FranciscoRozenberg/TDCE/README.md

Proyecto Integrador para cursada de Taller de Circuitos Electrónicos - 2C2026 - FIUBA
