FranciscoRozenberg/TDCE/capturas/Compensaciones/Screenshot_20260924_173537.png

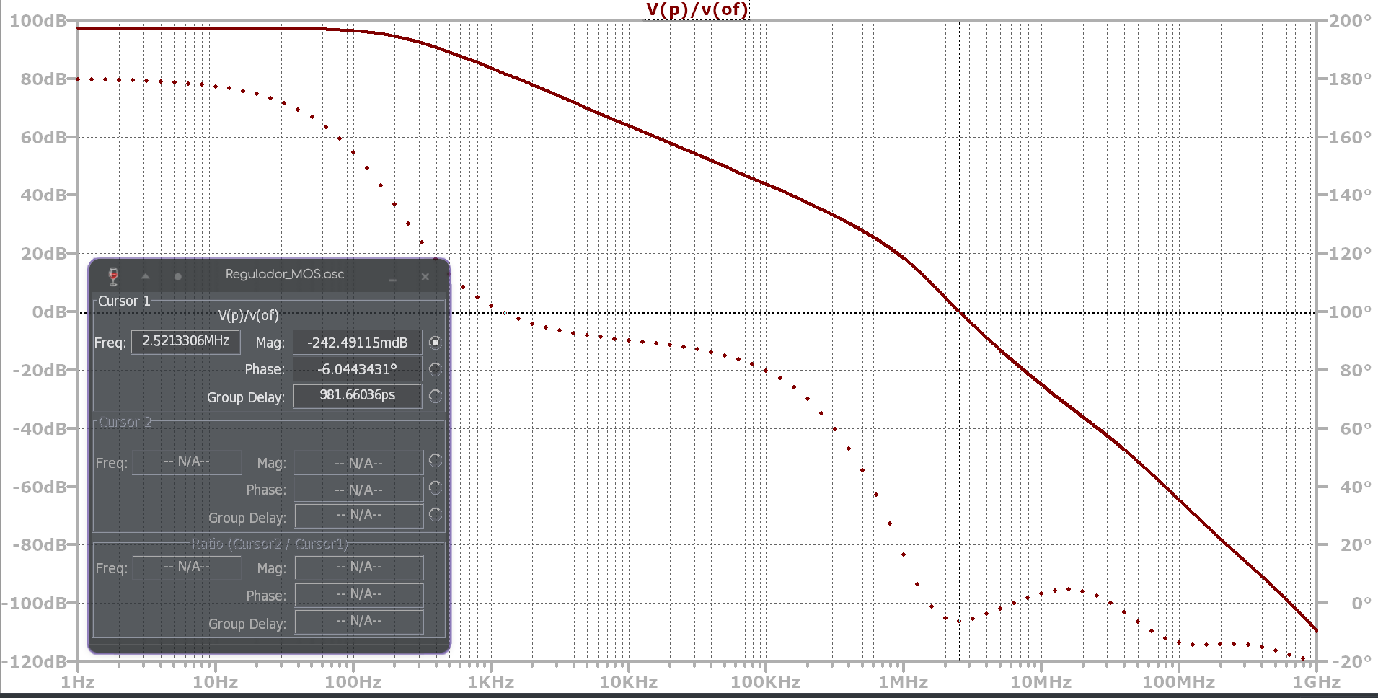
capturas/Compensaciones/Screenshot_20260924_173537.png
