FranciscoRozenberg/TDCE/capturas/Compensaciones/Screenshot_20260924_173708.png

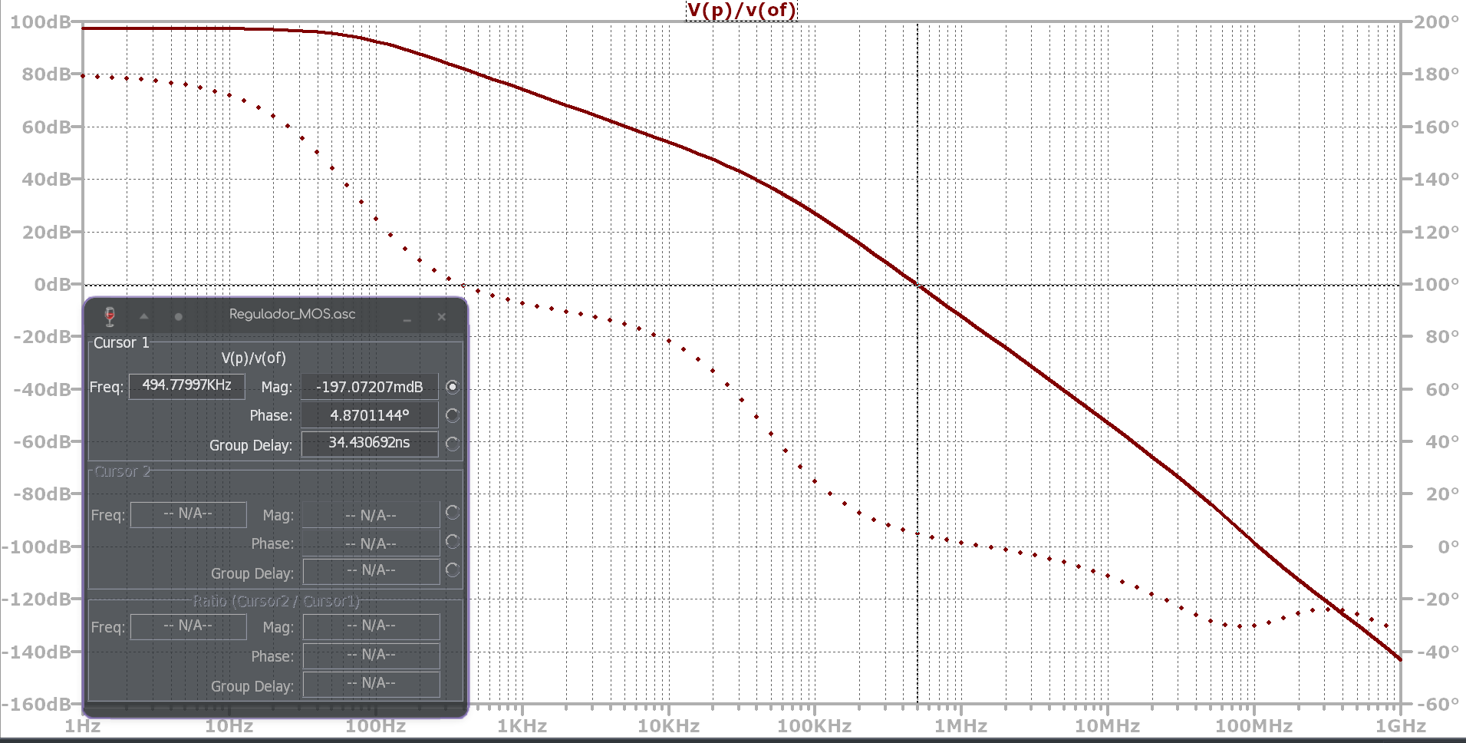
capturas/Compensaciones/Screenshot_20260924_173708.png
