FranciscoRozenberg/TDCE/capturas/Compensaciones/Screenshot_20260924_173938.png

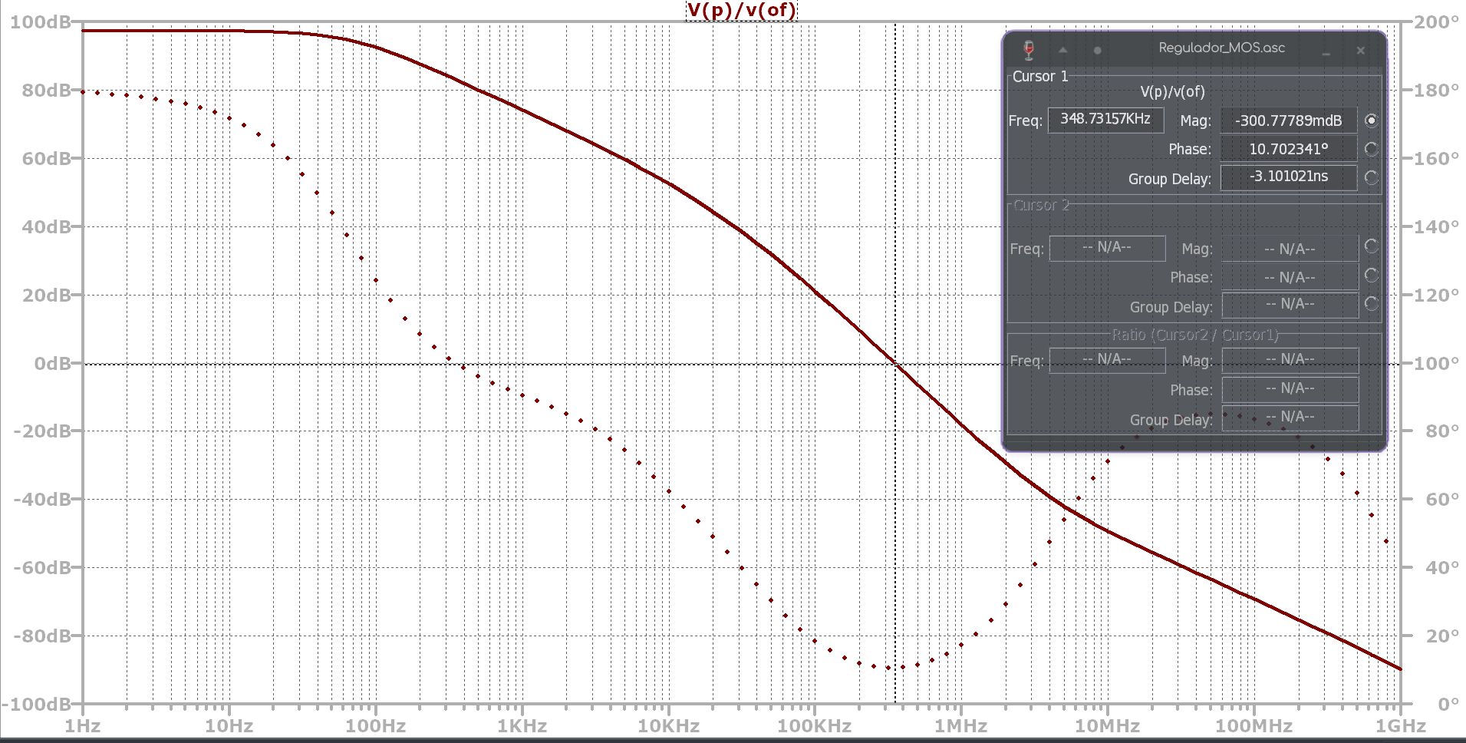
capturas/Compensaciones/Screenshot_20260924_173938.png
