FranciscoRozenberg/TDCE/capturas/Compensaciones/Screenshot_20260924_174028.png

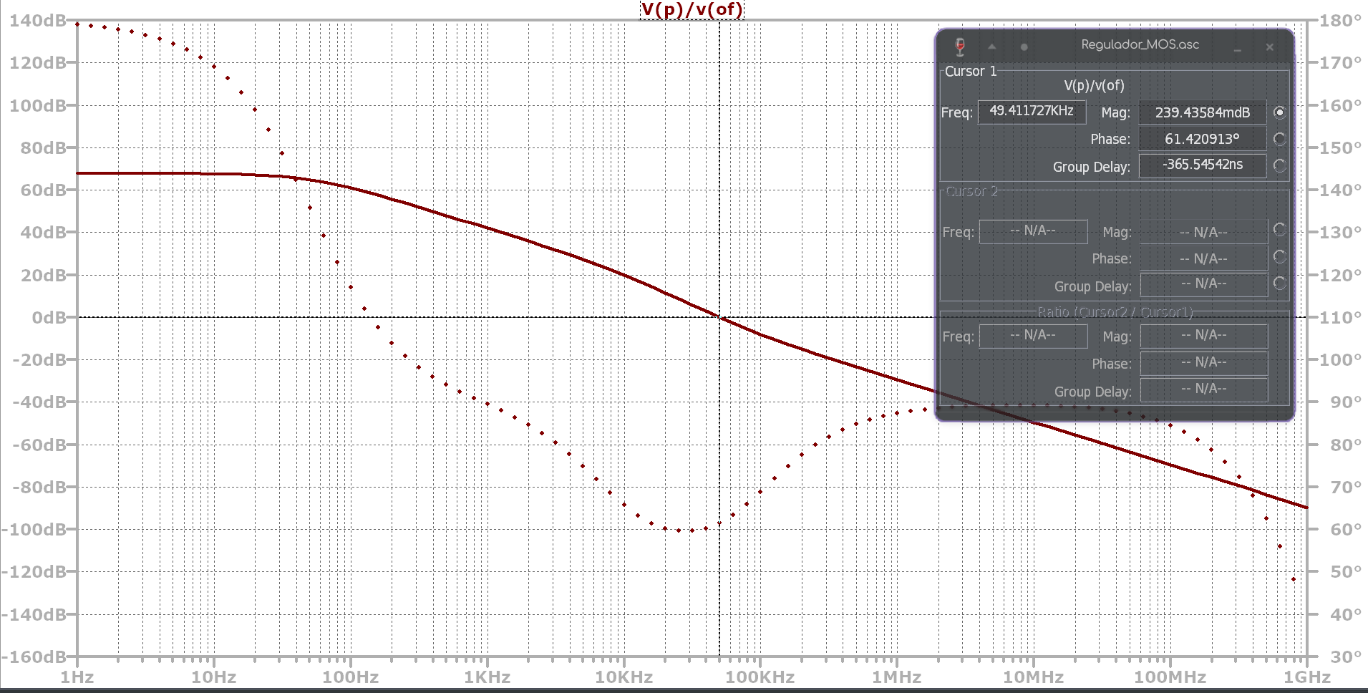
capturas/Compensaciones/Screenshot_20260924_174028.png
