FranciscoRozenberg/TDCE/capturas/Compensaciones/Screenshot_20260924_174857.png

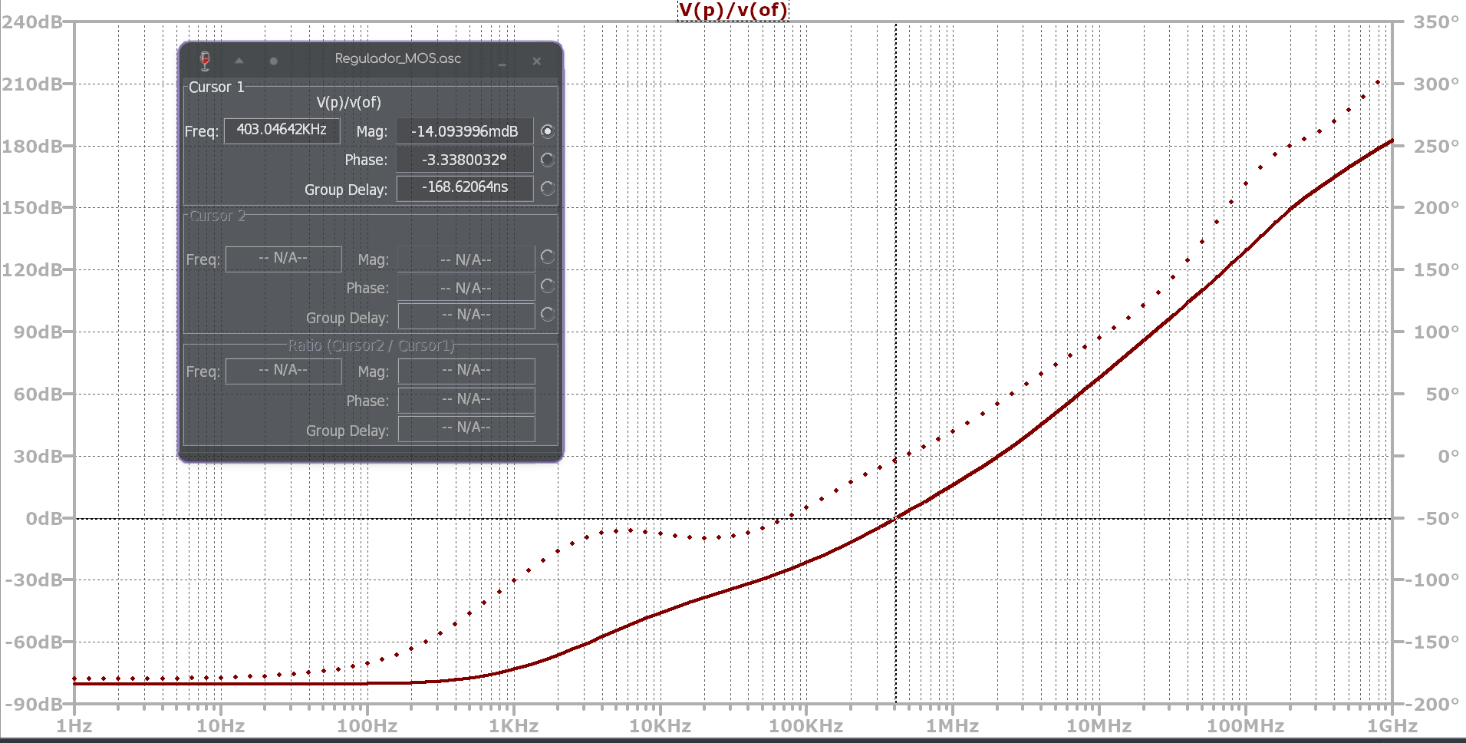
capturas/Compensaciones/Screenshot_20260924_174857.png
