FranciscoRozenberg/TDCE/capturas/Compensaciones/Screenshot_20260924_181137.png

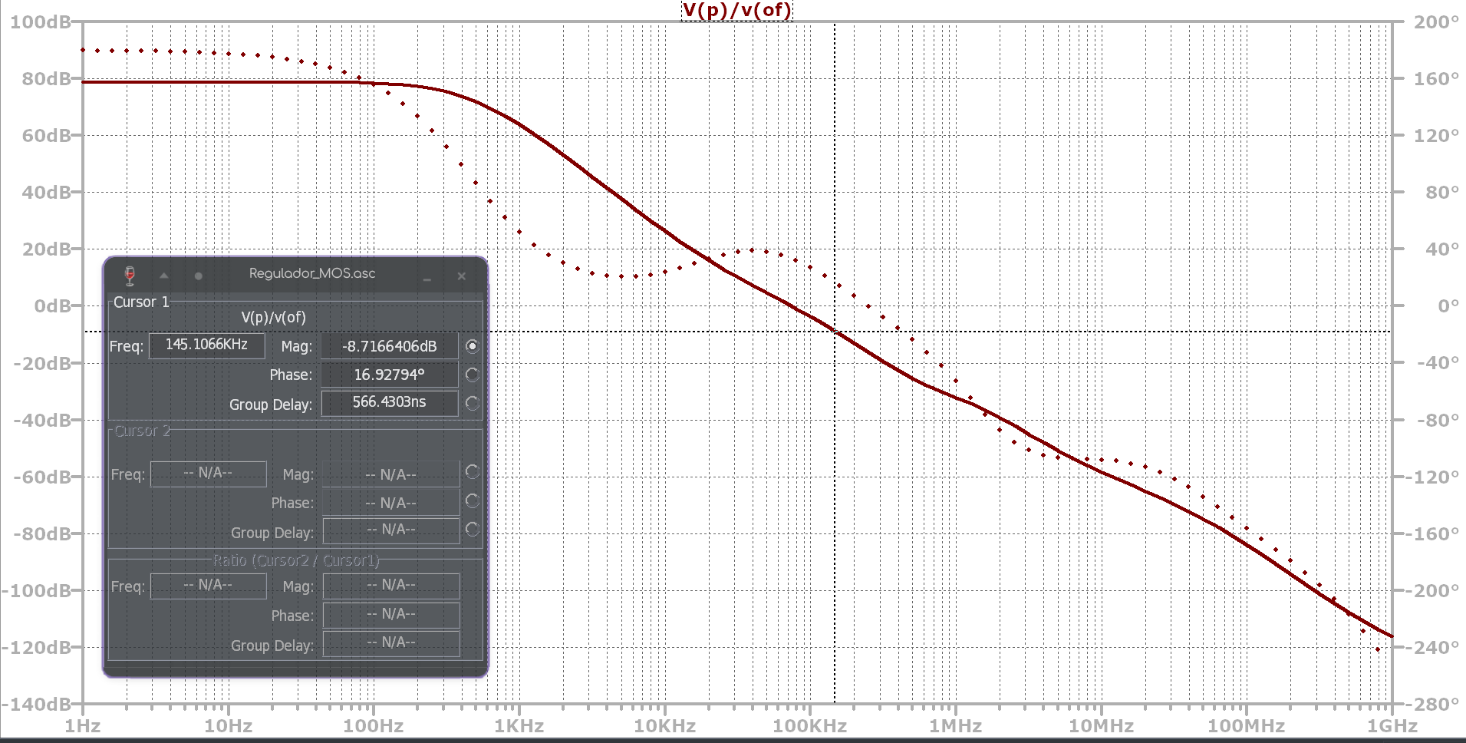
capturas/Compensaciones/Screenshot_20260924_181137.png
