FranciscoRozenberg/TDCE/capturas/Compensaciones/Screenshot_20260924_181226.png

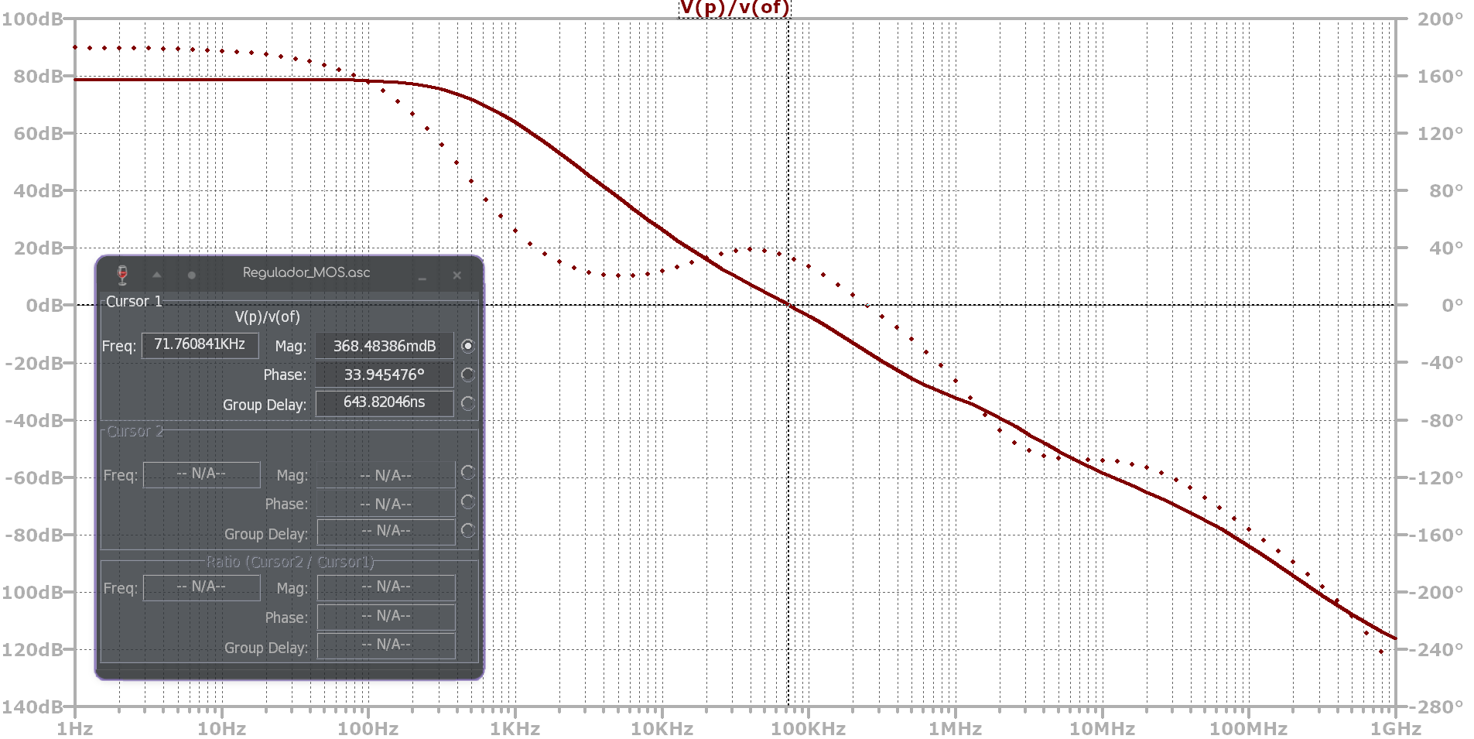
capturas/Compensaciones/Screenshot_20260924_181226.png
