FranciscoRozenberg/TDCE/capturas/foldback.jpg

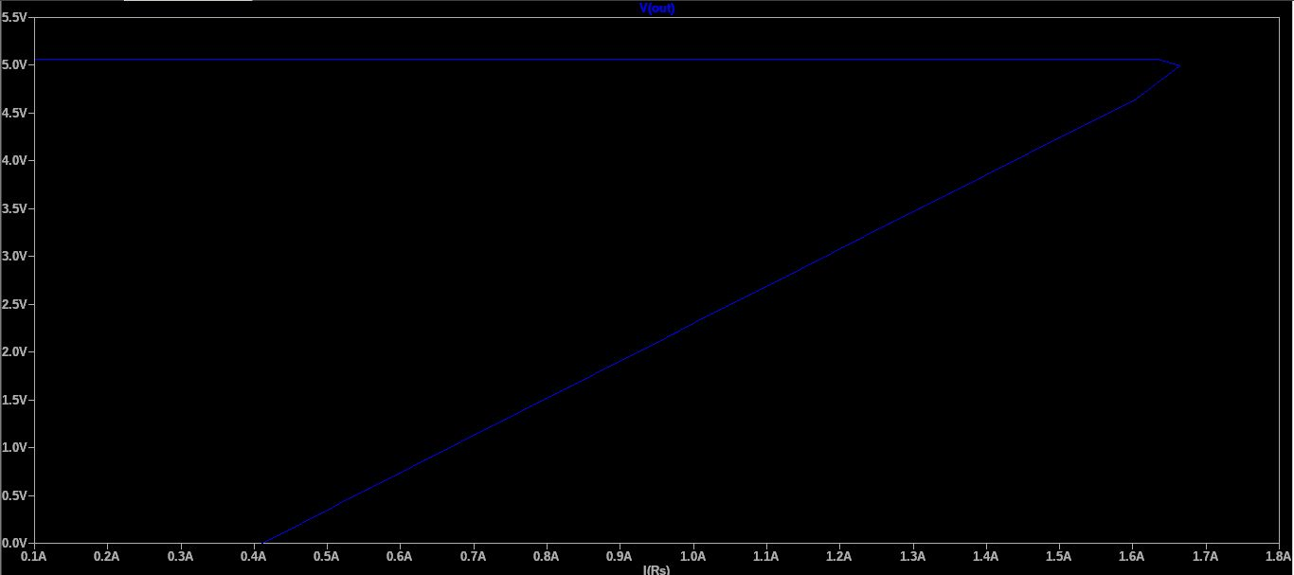
capturas/foldback.jpg
