FranciscoRozenberg/TDCE/capturas/MF_con_IRF9Z34N.png

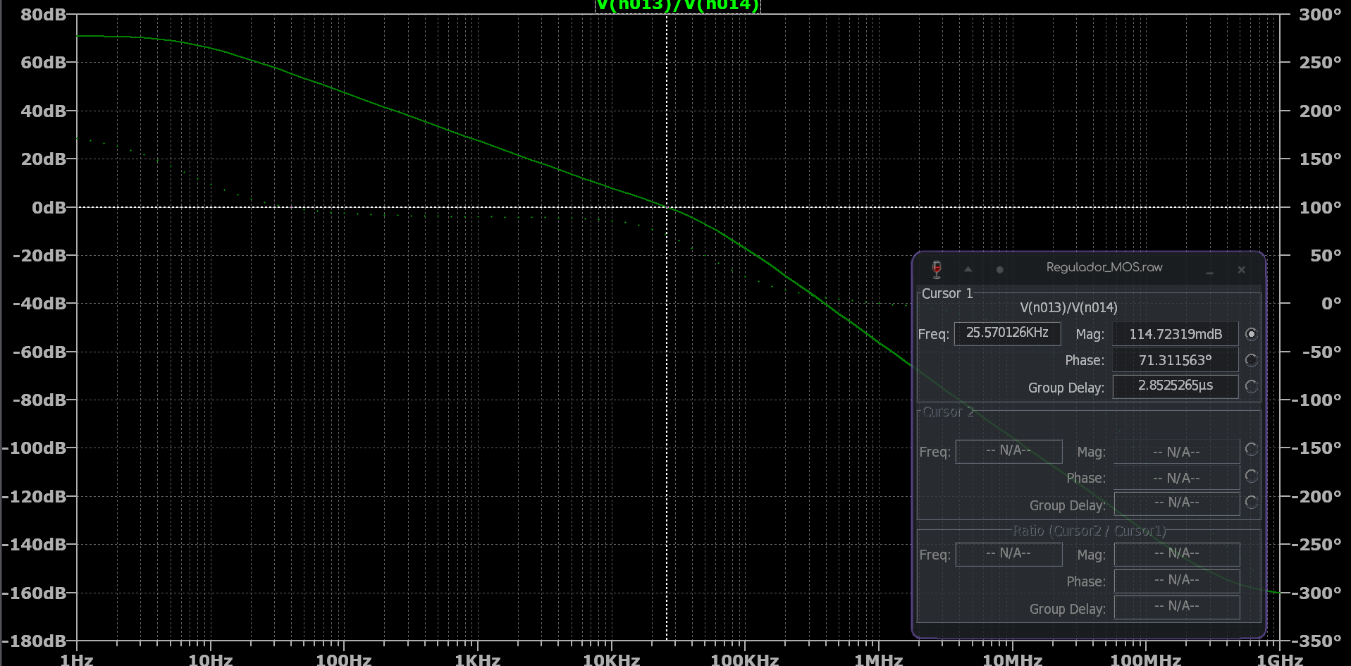
capturas/MF_con_IRF9Z34N.png
