FranciscoRozenberg/TDCE/capturas/PCB/PCB_DETRAS.png

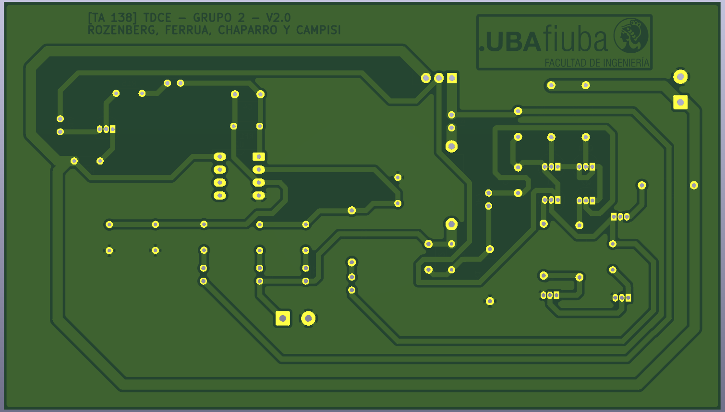
capturas/PCB/PCB_DETRAS.png
