FranciscoRozenberg/TDCE/capturas/screenshot regulador.png

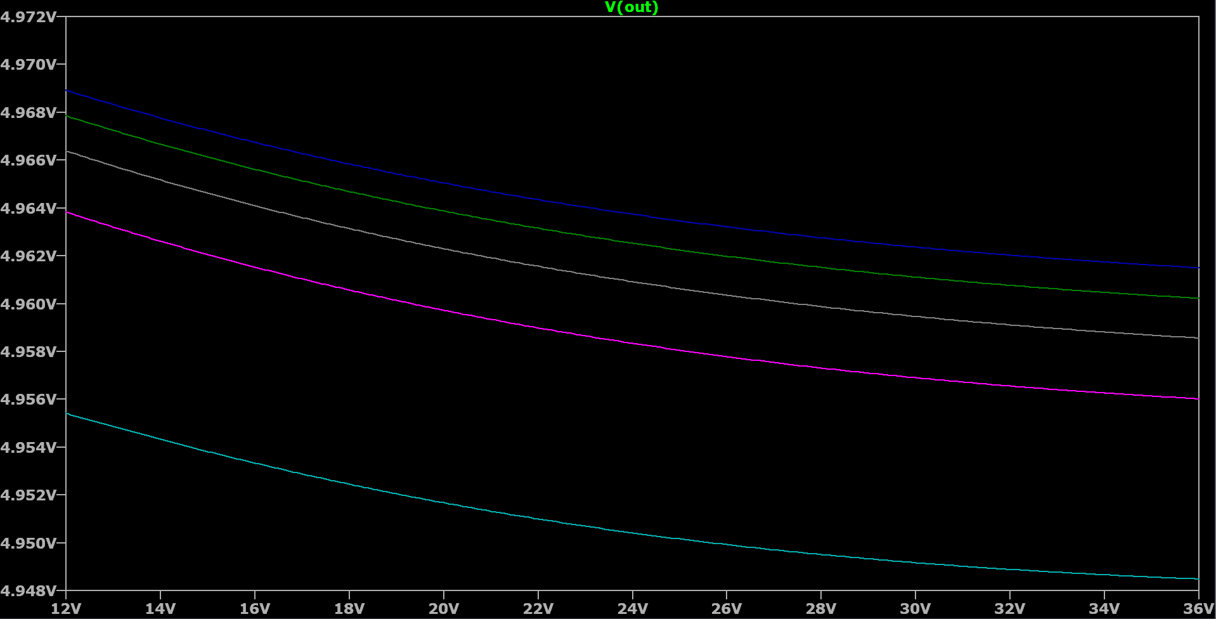
capturas/screenshot regulador.png
