FranciscoRozenberg/TDCE/IMG-20260925-WA0036.jpg

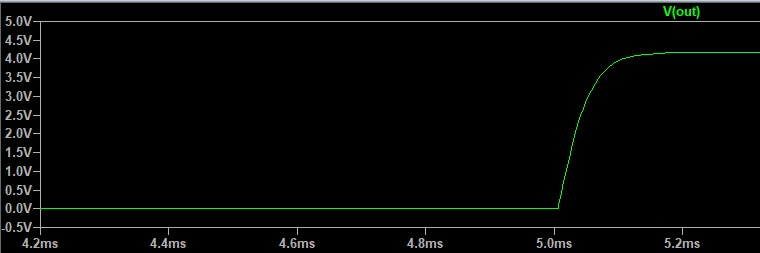
IMG-20260925-WA0036.jpg
