FranciscoRozenberg/TDCE/IMG-20260925-WA0037.jpg

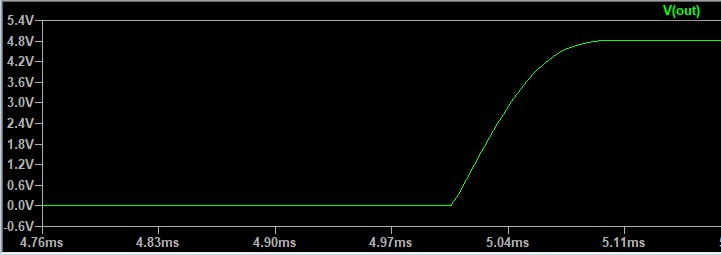
IMG-20260925-WA0037.jpg
