FranciscoRozenberg/TDCE/IMG-20260925-WA0038.jpg

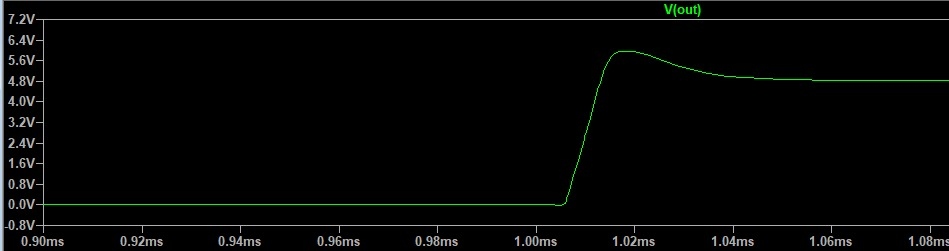
IMG-20260925-WA0038.jpg
