FranciscoRozenberg/TDCE/IMG-20260925-WA0039.jpg

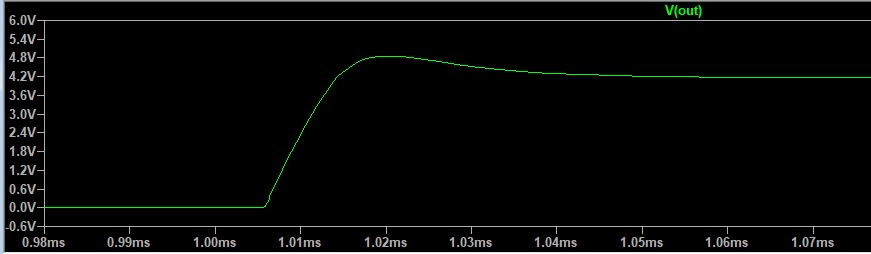
IMG-20260925-WA0039.jpg
