FranciscoRozenberg/TDCE/CH4_FUENTE_CONMUTADA/PWM_V2/pwm_V2/pwm_V2.csv

Reference | Qty | Value | DNP | Exclude from BOM | Exclude from Board | Exclude from Simulation | Exclude from Position Files | Footprint | Datasheet
C1 | 1 | 10n |  |  |  |  | ${EXCLUDE_FROM_POS_FILES} | Capacitor_THT:C_Disc_D10.0mm_W2.5mm_P5.00mm
C_FIL1 | 1 | 1n |  |  |  |  | ${EXCLUDE_FROM_POS_FILES} | Capacitor_THT:C_Disc_D10.0mm_W2.5mm_P5.00mm
J1,J2 | 2 | Screw_Terminal_01x02 |  |  |  |  | ${EXCLUDE_FROM_POS_FILES} | TerminalBlock:TerminalBlock_MaiXu_MX126-5.0-02P_1x02_P5.00mm
JP1,JP2,JP3,JP4 | 4 | Jumper_2_Bridged |  |  |  |  | ${EXCLUDE_FROM_POS_FILES} | TestPoint:TestPoint_2Pads_Pitch2.54mm_Drill0.8mm
R1 | 1 | 100k |  |  |  |  | ${EXCLUDE_FROM_POS_FILES} | Resistor_THT:R_Axial_DIN0207_L6.3mm_D2.5mm_P10.16mm_Horizontal
R5 | 1 | 8k2 |  |  |  |  | ${EXCLUDE_FROM_POS_FILES} | Resistor_THT:R_Axial_DIN0207_L6.3mm_D2.5mm_P10.16mm_Horizontal
RP1,RP2 | 2 | 10k |  |  |  |  | ${EXCLUDE_FROM_POS_FILES} | Potentiometer_THT:Potentiometer_Alps_RK163_Single_Horizontal
R_FIL1 | 1 | 100K |  |  |  |  | ${EXCLUDE_FROM_POS_FILES} | Resistor_THT:R_Axial_DIN0207_L6.3mm_D2.5mm_P10.16mm_Horizontal
R_PU1,R_PU2 | 2 | 220 |  |  |  |  | ${EXCLUDE_FROM_POS_FILES} | Resistor_THT:R_Axial_DIN0207_L6.3mm_D2.5mm_P10.16mm_Horizontal
U1 | 1 | TL082 |  |  |  |  | ${EXCLUDE_FROM_POS_FILES} | Package_DIP:DIP-8_W7.62mm_LongPads | http://www.ti.com/lit/ds/symlink/tl081.pdf
U2 | 1 | LM393 |  |  |  |  | ${EXCLUDE_FROM_POS_FILES} | Package_DIP:DIP-8_W7.62mm_LongPads | http://www.ti.com/lit/ds/symlink/lm393.pdf
V1 | 1 | VSIN |  |  |  |  | ${EXCLUDE_FROM_POS_FILES} | TerminalBlock:TerminalBlock_MaiXu_MX126-5.0-02P_1x02_P5.00mm | https://ngspice.sourceforge.io/docs/ngspice-html-manual/manual.xhtml#sec_Independent_Sources_for
V2 | 1 | 12 |  |  |  |  | ${EXCLUDE_FROM_POS_FILES} | TerminalBlock:TerminalBlock_MaiXu_MX126-5.0-02P_1x02_P5.00mm | https://ngspice.sourceforge.io/docs/ngspice-html-manual/manual.xhtml#sec_Independent_Sources_for
