FranciscoRozenberg/TDCE/CH4_FUENTE_CONMUTADA/PWM/print_pcb_pwm.pdf

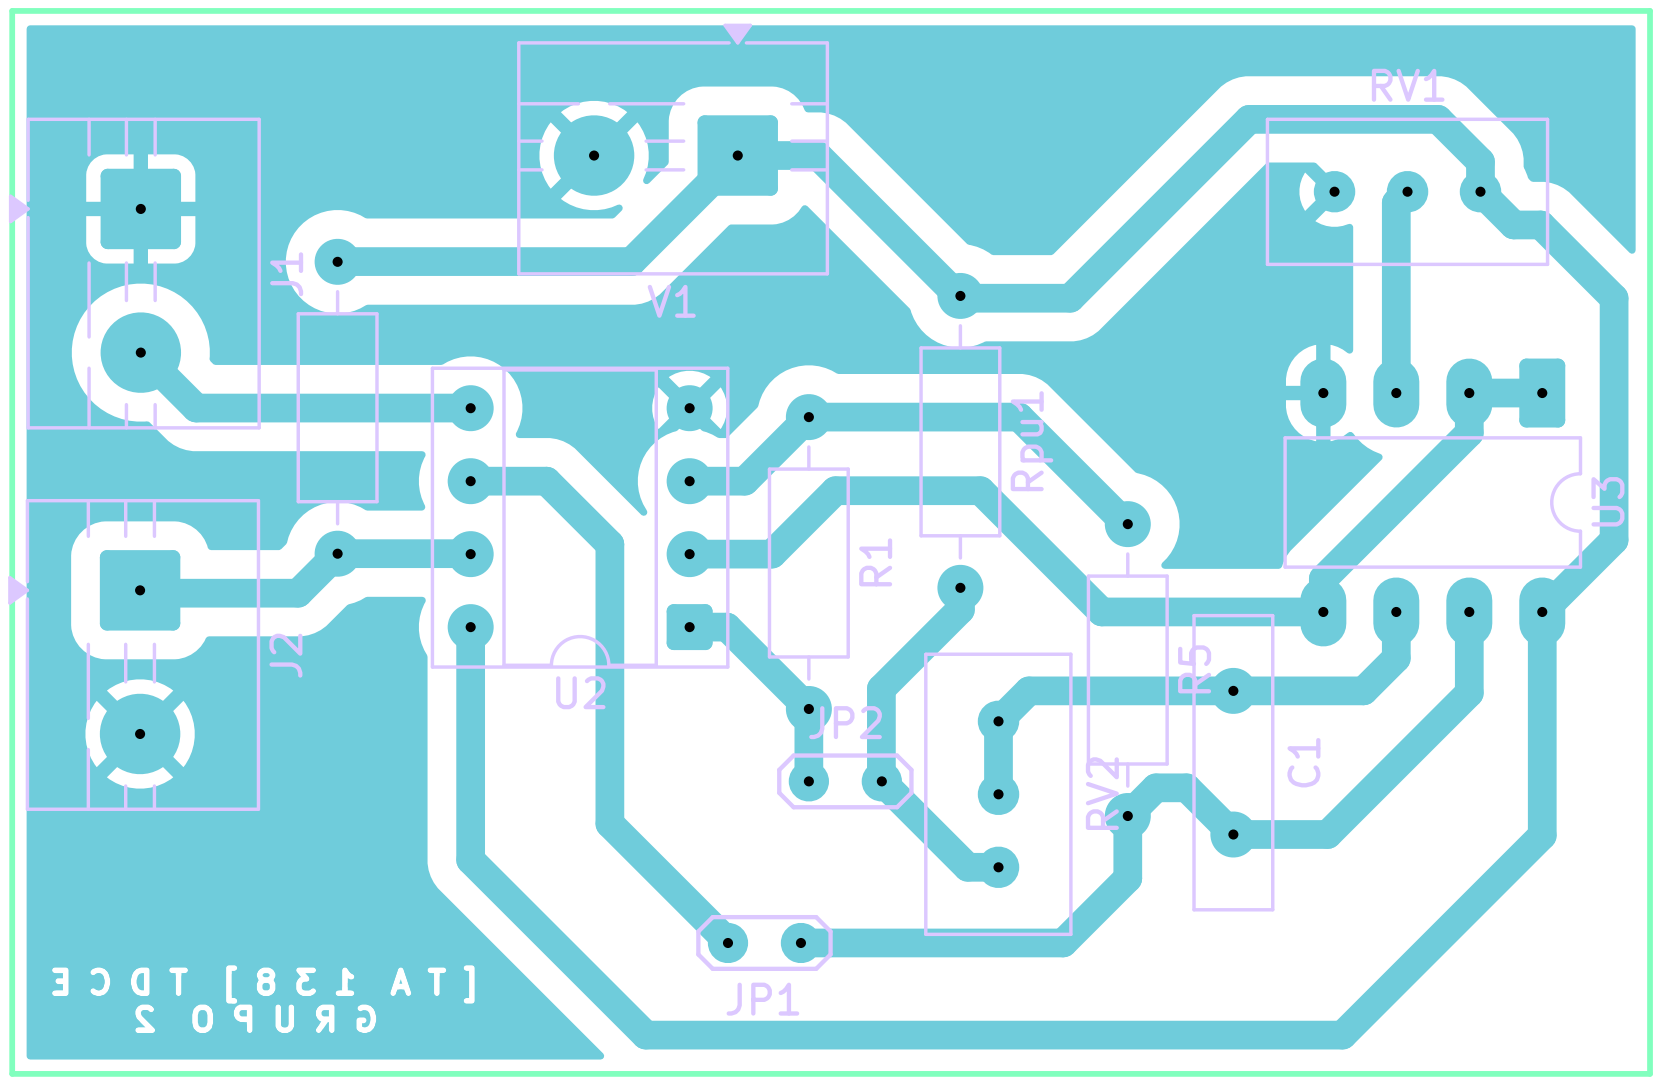
[picture p41: page 1]
