FranciscoRozenberg/TDCE/tests/Regulador_Diferencial_MOS.asc

M1: pmos; IRF9Z24S_L
Q1: npn; BC547C
Q2: npn; BC547C
Q3: npn; BC547C
Q4: npn; BC547C
Q5: pnp; BC557C
Q6: pnp; BC557C
R1: res; 10K
R2: res; 10K
R3: res; {RL}
R4: res; 3k3
R5: res; 6k6
V1: voltage; 7
VREF: voltage; 2.5
Named nets: 0, CC, OUT
;dc v1 4 7 0.1
.param RL 5
.op
