FranciscoRozenberg/TDCE/tests/Regulador_Diferencial.asc

I1: current; 1m
I2: current; 2m
Q1: npn
Q2: npn
Q3: npn
R1: res; 1k
R2: res; 1k
R3: res; {RL}
V1: voltage; 0
VREF: voltage; 2.5
Named nets: 0, CC
.dc v1 12 30 0.1
.step dec param RL 1m 10k 2
