FranciscoRozenberg/TDCE/tests/Regulador_Simple.asc

Q1: npn
Q2: npn
R1: res; 1k
R2: res; 1k
R3: res; {RL}
R4: res; 5k
V1: voltage; 0
V2: voltage; 1.8
Named nets: 0, CC
.dc v1 12 30 0.1
.step dec param RL 1m 10k 2
