FranciscoRozenberg/TDCE/Draft1.asc

C1: cap; 10n
R1: res; 100k
R2: res; 100k
R3: res; 100k
R4: res; 100k
R5: res; 47k
U1: opamp2
U2: opamp2
U3: opamp2
V1: voltage; 12
Named nets: 0, cc
.step param R 0 10k 2k
.op
.tran 0 1m 0 1u
