FranciscoRozenberg/TDCE/Regulador_MOS.asc

C1: cap; 1.5n
C2: cap; 820p
C3: cap; 1n
C4: cap; 1Meg
C5: cap; 1Meg
C6: cap; 15µ
C7: cap; 1n
L1: ind; 1Meg
L2: ind; 1Meg
M1: pmos; IRF9Z34N
Q1: pnp; BC557C
Q2: npn; BC547C
Q3: npn; BC547C
Q4: npn; BC547C
Q5: pnp; BC857C
Q6: pnp; BC857C
Q7: npn; BC547C
R1: res; 9.5k
R2: res; 39K
R3: res; 10.5k
R4: res; 1k8
R5: res; 39K
R6: res; 1k
R7: res; 1k
R8: res; 47K
R9: res; 47K
R10: res; 330k
R11: res; 1k
R12: res; 7k8
R13: res; 1
R14: res; 1
R15: res; 2.2k
R16: res; 2.2k
RF1: res; 330k
RL: res; 30
Rs: res; 0.1
Rz: res; 1k
U1: TL431
U2: lm358
V1: voltage; PULSE(0 2.5 100u 0 0 1ms 1ms)
V2: voltage; 0; AC 1
V3: voltage; 0; AC 1
VIN: voltage; {VINDC}; AC {VINAC}
Named nets: 0, CC, IN, OUT, VB, p, of
;step param RL 0.1 20 1
.op
Mido regulacion de linea
;.meas DC Vo1rl FIND V(out) AT=12
;.meas DC Vo2rl FIND V(out) AT=24
;.meas DC RegLin PARAM ((Vo2rl-Vo1rl)/12)
Mido regulacion de carga
;.meas OP Vo1rc FIND V(Vo) AT 100
;.meas OP Vo2rc FIND V(Vo) AT 5
;.meas OP Io1rc FIND I(RL) AT 100
;.meas OP Io2rc FIND I(RL) AT 5
Mido eficiencia
.param VINDC=10
.param VINAC 0
;.meas eficiencia PARAM -100*((V(out)*I(RL))/(V(CC)*I(VIN)))
.include IRF9Z34N.mod
.ac dec   10  1 1G
.dc VIN 5.5 6.5 0.01
.tran 2ms
