FranciscoRozenberg/TDCE/CH4_FUENTE_CONMUTADA/pwm1.asc

C1: cap; 1n
R1: res; 100k
R5: res; 8k2
Rp2: res; 10k
Rp3: res; 5k
Rp4: res; 5k
Rpu1: res; 220
Rpu2: res; 220
U1: opamp2; LM393A
U2: opamp2; TL072
U3: opamp2; TL072
U4: opamp2; LM393A
V1: voltage; 12
V2: voltage; SINE(6 1 12k)
Named nets: 0, cc, out
.step param R 0 10k 2k
.op
.tran 0 30u 0 1u
.include LM324.lib
.include LM393.lib
.include TL072.lib
