FranciscoRozenberg/TDCE/CH4_FUENTE_CONMUTADA/pwm_324.asc

C1: cap; 100p
R1: res; 100k
R2: res; 1k
R3: res; 1K5
R5: res; 27k
Rp2: res; 1K
Rp3: res; 5k
Rp4: res; 5k
Rpu1: res; 330
Rpu2: res; 330
U1: opamp2; LM393A
U2: opamp2; LM324
U3: opamp2; LM324
U4: opamp2; LM393A
V1: voltage; 12
V2: voltage; SINE(4 4 12k)
Named nets: 0, cc, out
.step param R 0 10k 2k
.op
.tran 0 30u 0 1u
.include LM324.lib
.include LM393.lib
.include TL072.lib
