FranciscoRozenberg/TDCE/CH4_FUENTE_CONMUTADA/PWM_V2/pwm_V2/pwm_V2.kicad_pcb

## KiCad design CH4_FUENTE_CONMUTADA/PWM_V2/pwm_V2/pwm_V2.kicad_pcb (2026-11-12)

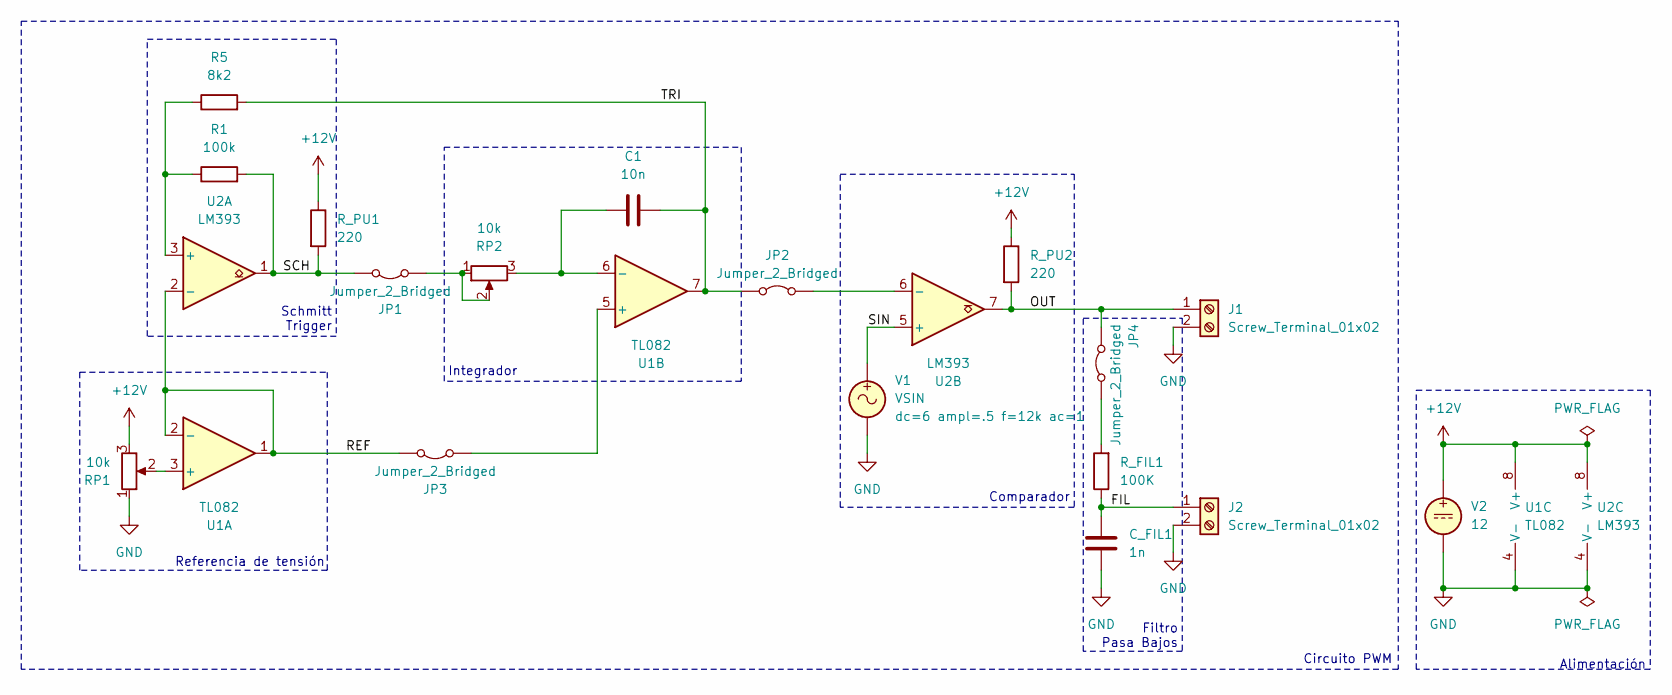
[picture p42: schematic pwm_V2.kicad_sch]

Parts:
C1: 10n; C_Disc_D10.0mm_W2.5mm_P5.00mm
C_FIL1: 1n; C_Disc_D10.0mm_W2.5mm_P5.00mm
J1, J2: Screw_Terminal_01x02; TerminalBlock_MaiXu_MX126-5.0-02P_1x02_P5.00mm
JP1, JP2, JP3, JP4: Jumper_2_Bridged; TestPoint_2Pads_Pitch2.54mm_Drill0.8mm
R1: 100k; R_Axial_DIN0207_L6.3mm_D2.5mm_P10.16mm_Horizontal
R5: 8k2; R_Axial_DIN0207_L6.3mm_D2.5mm_P10.16mm_Horizontal
RP1, RP2: 10k; Potentiometer_Alps_RK163_Single_Horizontal
R_FIL1: 100K; R_Axial_DIN0207_L6.3mm_D2.5mm_P10.16mm_Horizontal
R_PU1, R_PU2: 220; R_Axial_DIN0207_L6.3mm_D2.5mm_P10.16mm_Horizontal
U1: TL082; DIP-8_W7.62mm_LongPads
U2: LM393; DIP-8_W7.62mm_LongPads
V1: VSIN; TerminalBlock_MaiXu_MX126-5.0-02P_1x02_P5.00mm
V2: 12; TerminalBlock_MaiXu_MX126-5.0-02P_1x02_P5.00mm

Connections:
+12V: RP1.3, R_PU1.1, R_PU2.1, U1.8 (V+), U2.8 (V+), V2.1
/FIL: C_FIL1.1, J2.1, R_FIL1.1
/OUT: J1.1, JP4.2 (B), R_PU2.2, U2.7
/REF: JP3.1 (A), U1.1, U1.2 (-), U2.2 (-)
/SCH: JP1.1 (A), R1.2, R_PU1.2, U2.1
/SIN: U2.5 (+), V1.1
/TRI: C1.2, JP2.1 (A), R5.2, U1.7
GND: C_FIL1.2, J1.2, J2.2, RP1.1, U1.4 (V-), U2.4 (V-), V1.2, V2.2
unnamed: JP1.2 (B), RP2.1, RP2.2
unnamed: JP2.2 (B), U2.6 (-)
unnamed: JP3.2 (B), U1.5 (+)
unnamed: JP4.1 (A), R_FIL1.2
unnamed: RP1.2, U1.3 (+)
unnamed: C1.1, RP2.3, U1.6 (-)
unnamed: R1.1, R5.1, U2.3 (+)

Notes on the sheet:
Integrador
Referencia de tensión
Schmitt Trigger
Filtro Pasa Bajos
Alimentación
Circuito PWM
Comparador

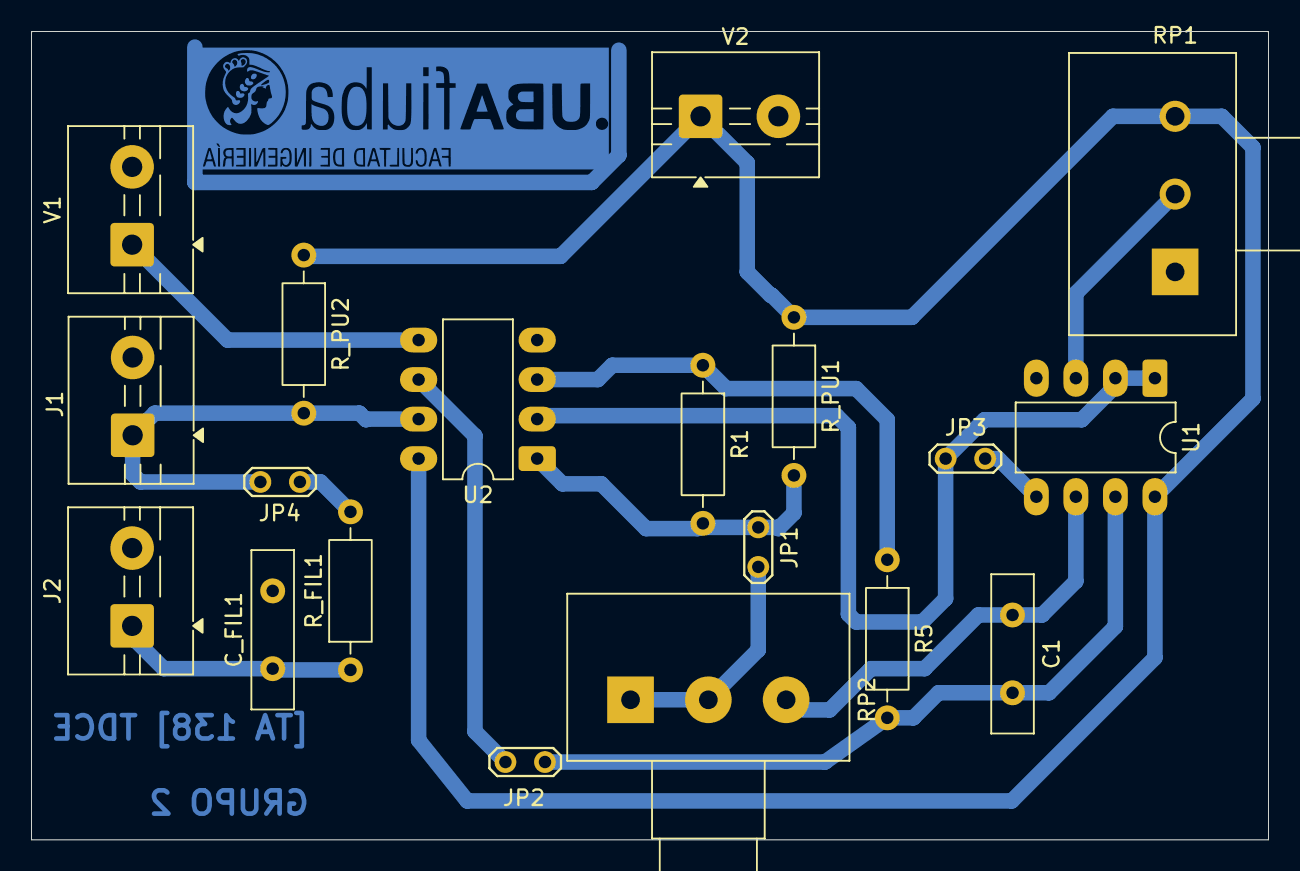
[picture p43: board pwm_V2.kicad_pcb from above]

Board: 2 copper layers, 79.5 x 52.0 mm, 19 parts (0 on the bottom side), 15 nets.
