FranciscoRozenberg/TDCE/CH4_FUENTE_CONMUTADA/PWM/PWM.kicad_pcb

## KiCad design CH4_FUENTE_CONMUTADA/PWM/PWM.kicad_pcb (2026-11-07, an earlier design)

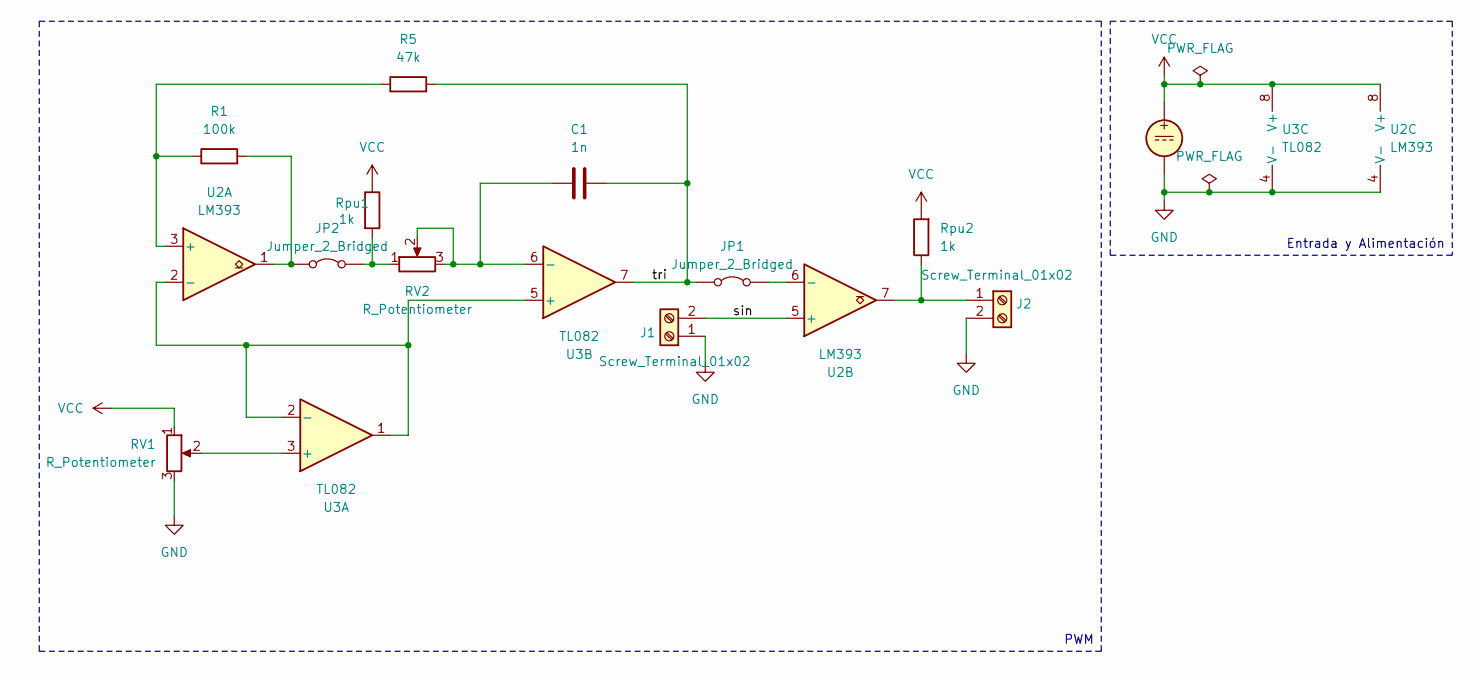
[picture p44: schematic PWM.kicad_sch]

Parts:
C1: 1n; C_Disc_D10.0mm_W2.5mm_P5.00mm
J1, J2: Screw_Terminal_01x02; TerminalBlock_MaiXu_MX126-5.0-02P_1x02_P5.00mm
JP1, JP2: Jumper_2_Bridged; TestPoint_2Pads_Pitch2.54mm_Drill0.8mm
R1: 100k; R_Axial_DIN0207_L6.3mm_D2.5mm_P10.16mm_Horizontal
R5: 47k; R_Axial_DIN0207_L6.3mm_D2.5mm_P10.16mm_Horizontal
RV1, RV2: R_Potentiometer; Potentiometer_Bourns_3296W_Vertical
Rpu1, Rpu2: 1k; R_Axial_DIN0207_L6.3mm_D2.5mm_P10.16mm_Horizontal
U2: LM393; DIP-8_W7.62mm_Socket
U3: TL082; DIP-8_W7.62mm_LongPads
V1: 12; TerminalBlock_MaiXu_MX126-5.0-02P_1x02_P5.00mm

Connections:
/sin: J1.2, U2.5 (+)
/tri: C1.2, JP1.1 (A), R5.2, U3.7
GND: J1.1, J2.2, RV1.3, U2.4 (V-), U3.4 (V-), V1.2
unnamed: J2.1, Rpu2.1, U2.7
unnamed: JP1.2 (B), U2.6 (-)
unnamed: JP2.1 (A), R1.2, U2.1
unnamed: JP2.2 (B), RV2.1, Rpu1.2
unnamed: R1.1, R5.1, U2.3 (+)
unnamed: U2.2 (-), U3.1, U3.2 (-), U3.5 (+)
unnamed: RV1.2, U3.3 (+)
unnamed: C1.1, RV2.2, RV2.3, U3.6 (-)
VCC: RV1.1, Rpu1.1, Rpu2.2, U2.8 (V+), U3.8 (V+), V1.1

Notes on the sheet:
PWM
Entrada y Alimentación

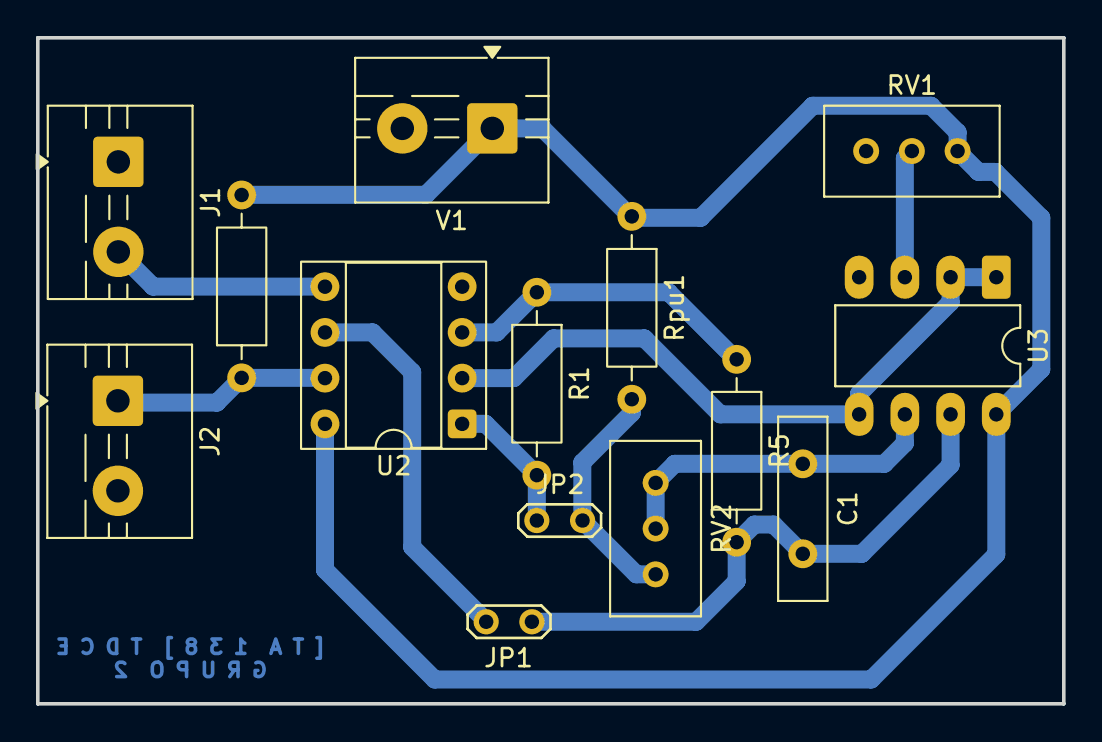
[picture p45: board PWM.kicad_pcb from above]

Board: 2 copper layers, 57.0 x 37.0 mm, 14 parts (0 on the bottom side), 12 nets.
