FranciscoRozenberg/TDCE/CH2_Esquema_y_PCB/Esquema_y_PCB.kicad_pcb

## KiCad design CH2_Esquema_y_PCB/Esquema_y_PCB.kicad_pcb (2026-10-04)

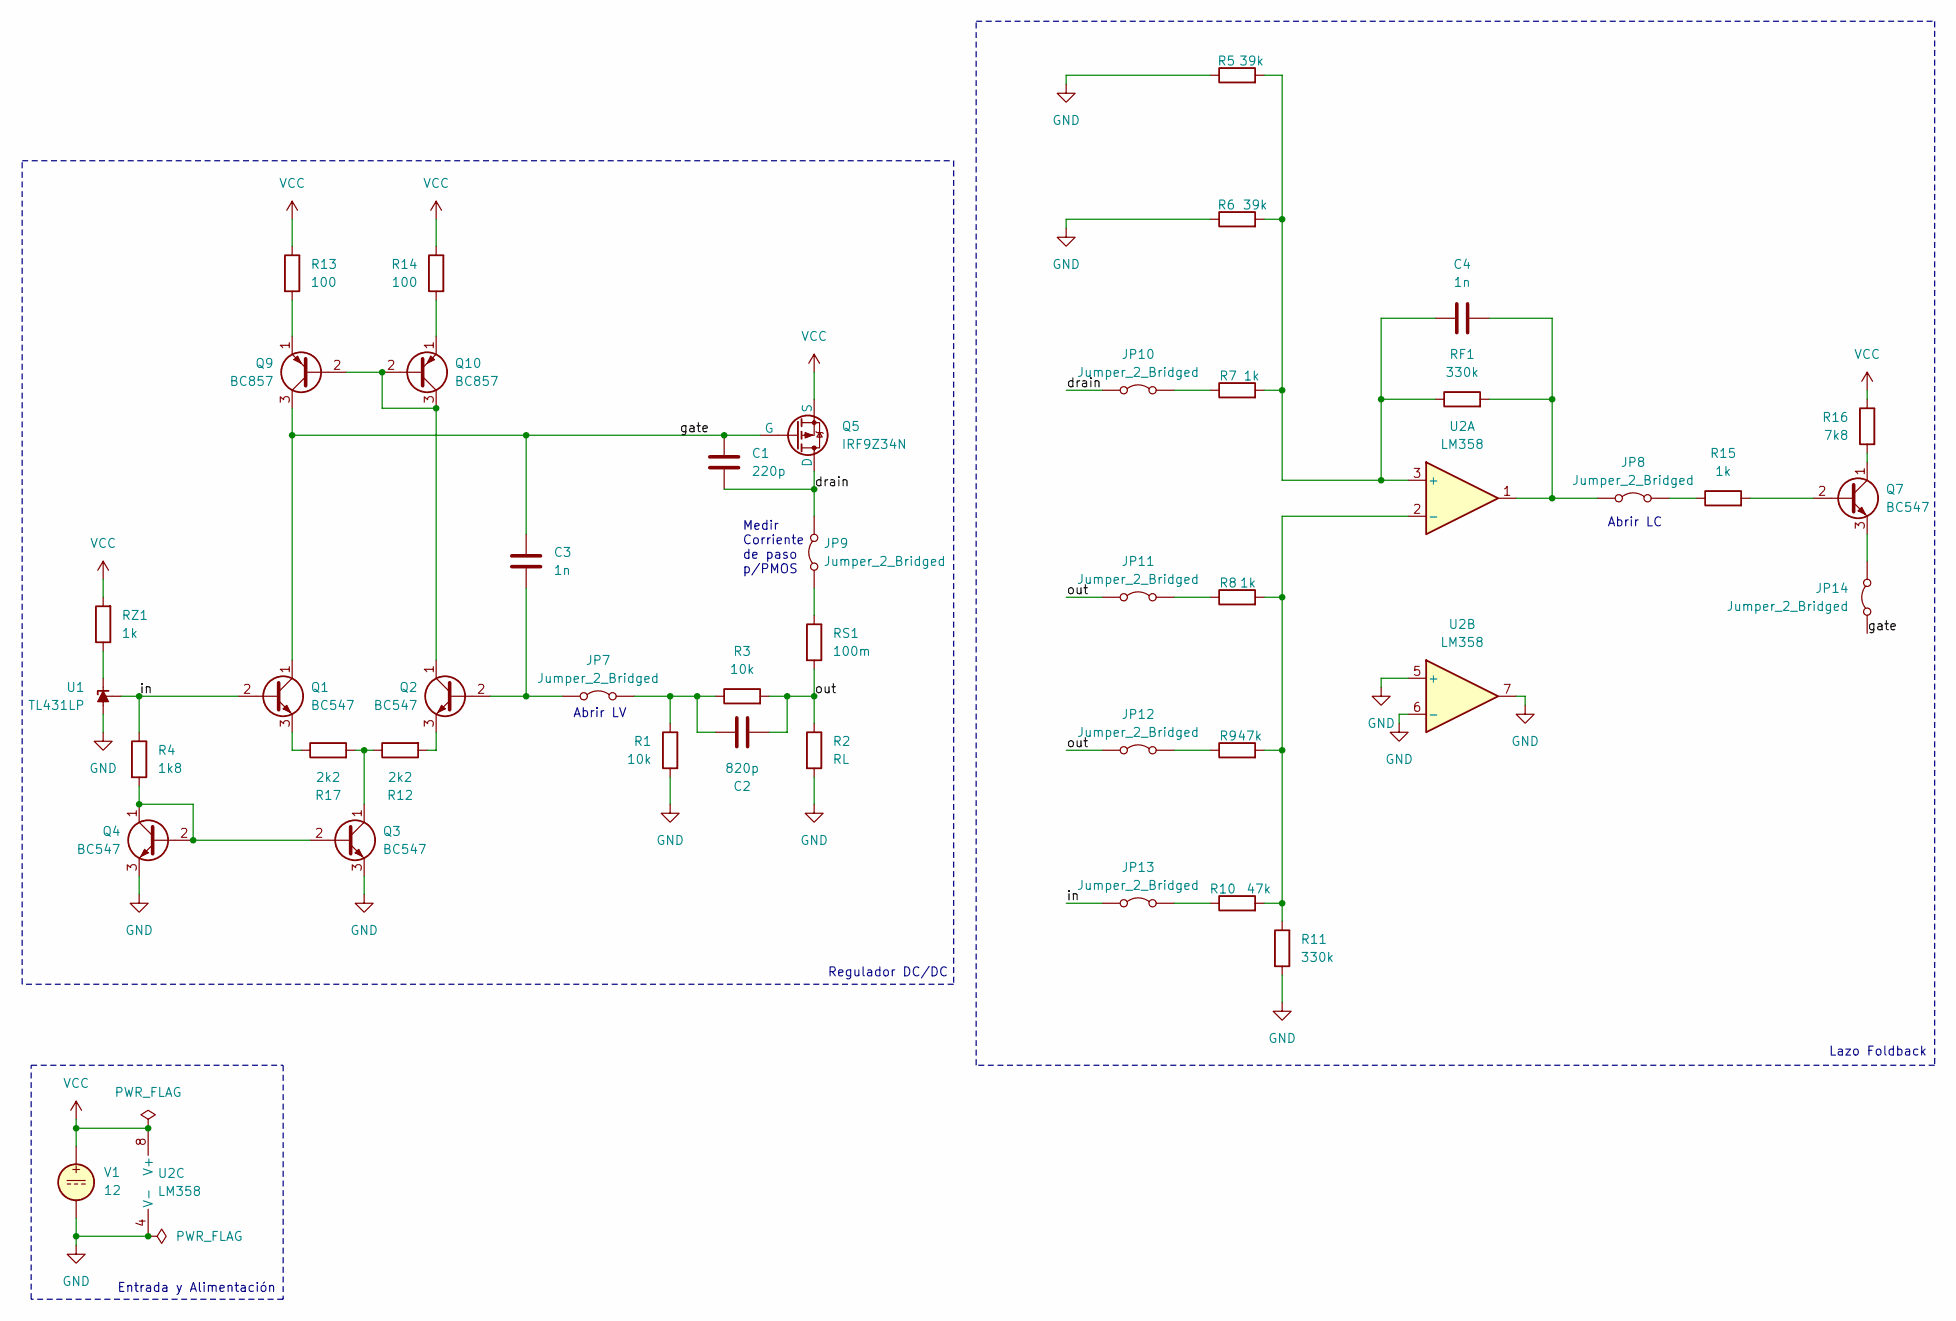
[picture p46: schematic Esquema_y_PCB.kicad_sch, Trabajo Práctico Integrador]

Parts:
C1: 220p; C_Disc_D5.0mm_W2.5mm_P5.00mm
C2: 820p; C_Disc_D7.5mm_W5.0mm_P7.50mm
C3: 1n; C_Disc_D7.5mm_W5.0mm_P7.50mm
C4: 1n; C_Disc_D5.0mm_W2.5mm_P5.00mm
JP7, JP8, JP9, JP10, JP11, JP12, JP13, JP14: Jumper_2_Bridged; TestPoint_2Pads_Pitch2.54mm_Drill0.8mm
Q1, Q2, Q3, Q4, Q7: BC547; TO-92_Wide
Q5: IRF9Z34N; TO-220-3_Vertical
Q9, Q10: BC857; TO-92_Wide
R1, R3: 10k; R_Axial_DIN0207_L6.3mm_D2.5mm_P10.16mm_Horizontal
R2: RL; TerminalBlock_MaiXu_MX126-5.0-02P_1x02_P5.00mm
R4: 1k8; R_Axial_DIN0207_L6.3mm_D2.5mm_P10.16mm_Horizontal
R5, R6: 39k; R_Axial_DIN0207_L6.3mm_D2.5mm_P10.16mm_Horizontal
R7, R8, R15: 1k; R_Axial_DIN0207_L6.3mm_D2.5mm_P10.16mm_Horizontal
R9, R10: 47k; R_Axial_DIN0207_L6.3mm_D2.5mm_P10.16mm_Horizontal
R11: 330k; R_Axial_DIN0207_L6.3mm_D2.5mm_P10.16mm_Horizontal
R12, R17: 2k2; R_Axial_DIN0207_L6.3mm_D2.5mm_P10.16mm_Horizontal
R13, R14: 100; R_Axial_DIN0207_L6.3mm_D2.5mm_P10.16mm_Horizontal
R16: 7k8; R_Axial_DIN0207_L6.3mm_D2.5mm_P10.16mm_Horizontal
RF1: 330k; R_Axial_DIN0207_L6.3mm_D2.5mm_P10.16mm_Horizontal
RS1: 100m; R_Axial_Power_L20.0mm_W6.4mm_P25.40mm
RZ1: 1k; R_Axial_DIN0207_L6.3mm_D2.5mm_P10.16mm_Horizontal
U1: TL431LP; TO-92_Wide
U2: LM358; DIP-8_W7.62mm_Socket_LongPads
V1: 12; TerminalBlock_MaiXu_MX126-5.0-02P_1x02_P5.00mm

Connections:
/drain: C1.2, JP9.2 (B), JP10.1 (A), Q5.2 (D)
/gate: C1.1, C3.1, JP14.2 (B), Q1.1 (C), Q5.1 (G), Q9.3 (C)
/in: JP13.1 (A), Q1.2 (B), R4.1, U1.1 (REF)
/out: C2.2, JP11.1 (A), JP12.1 (A), R2.1, R3.2, RS1.2
GND: Q3.3 (E), Q4.3 (E), R1.2, R2.2, R5.1, R6.1, R11.2, U1.2 (A), U2.4 (V-), U2.5 (+), U2.6 (-), U2.7, V1.2
unnamed: C3.2, JP7.1 (A), Q2.2 (B)
unnamed: C2.1, JP7.2 (B), R1.1, R3.1
unnamed: C4.2, JP8.1 (A), RF1.2, U2.1
unnamed: JP8.2 (B), R15.1
unnamed: JP9.1 (A), RS1.1
unnamed: JP10.2 (B), R7.1
unnamed: JP11.2 (B), R8.1
unnamed: JP12.2 (B), R9.1
unnamed: JP13.2 (B), R10.1
unnamed: JP14.1 (A), Q7.3 (E)
unnamed: Q1.3 (E), R17.1
unnamed: Q2.3 (E), R12.2
unnamed: Q3.2 (B), Q4.1 (C), Q4.2 (B), R4.2
unnamed: Q3.1 (C), R12.1, R17.2
unnamed: Q7.2 (B), R15.2
unnamed: Q7.1 (C), R16.2
unnamed: Q9.1 (E), R13.2
unnamed: Q2.1 (C), Q9.2 (B), Q10.2 (B), Q10.3 (C)
unnamed: Q10.1 (E), R14.2
unnamed: RZ1.1, U1.3 (K)
unnamed: C4.1, R5.2, R6.2, R7.2, RF1.1, U2.3 (+)
unnamed: R8.2, R9.2, R10.2, R11.1, U2.2 (-)
VCC: Q5.3 (S), R13.1, R14.1, R16.1, RZ1.2, U2.8 (V+), V1.1

Notes on the sheet:
Abrir LV
Medir Corriente de paso p/PMOS
Lazo Foldback
Regulador DC/DC
Abrir LC
Entrada y Alimentación

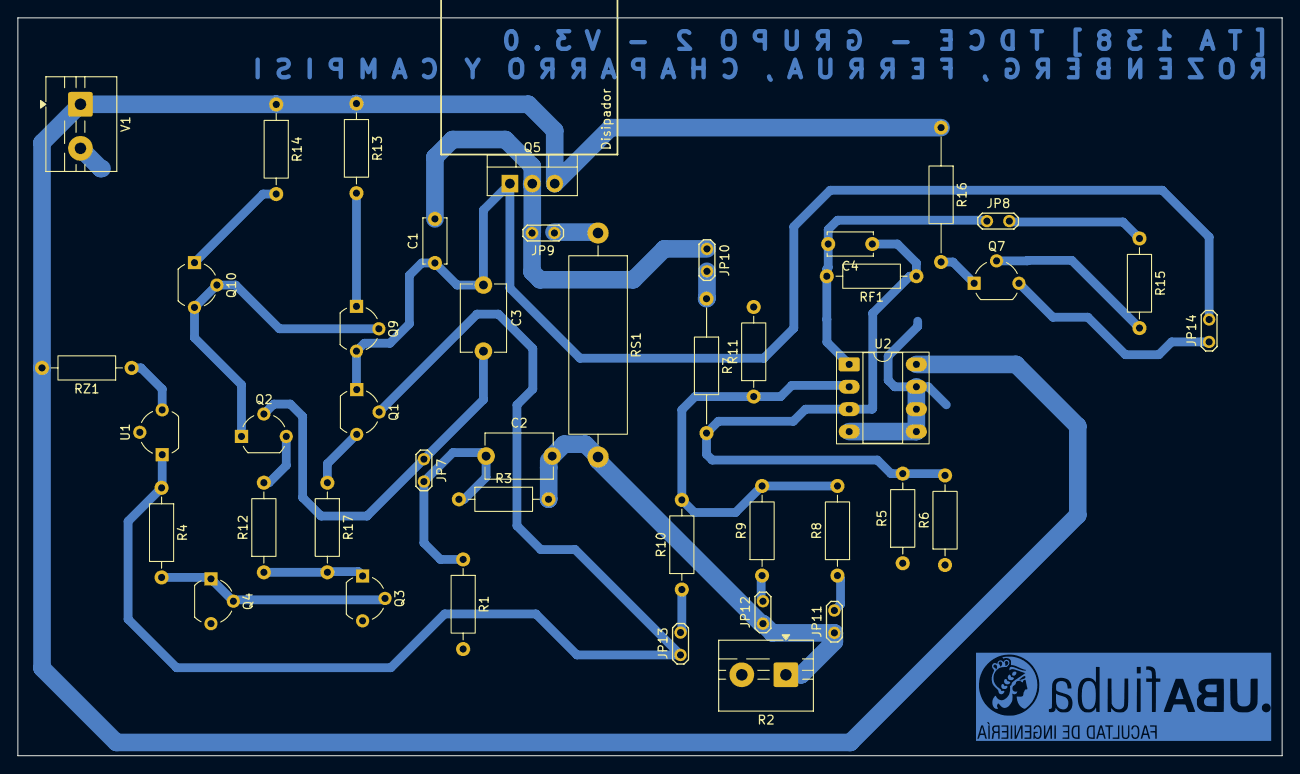
[picture p47: board CH2_Esquema_y_PCB/Esquema_y_PCB.kicad_pcb from above]

Board: 2 copper layers, 143.4 x 83.7 mm, 43 parts (0 on the bottom side), 28 nets.
