FranciscoRozenberg/TDCE/CH1_Esquema_y_PCB/Esquema_y_PCB.kicad_pcb

## KiCad design CH1_Esquema_y_PCB/Esquema_y_PCB.kicad_pcb (2026-09-09)

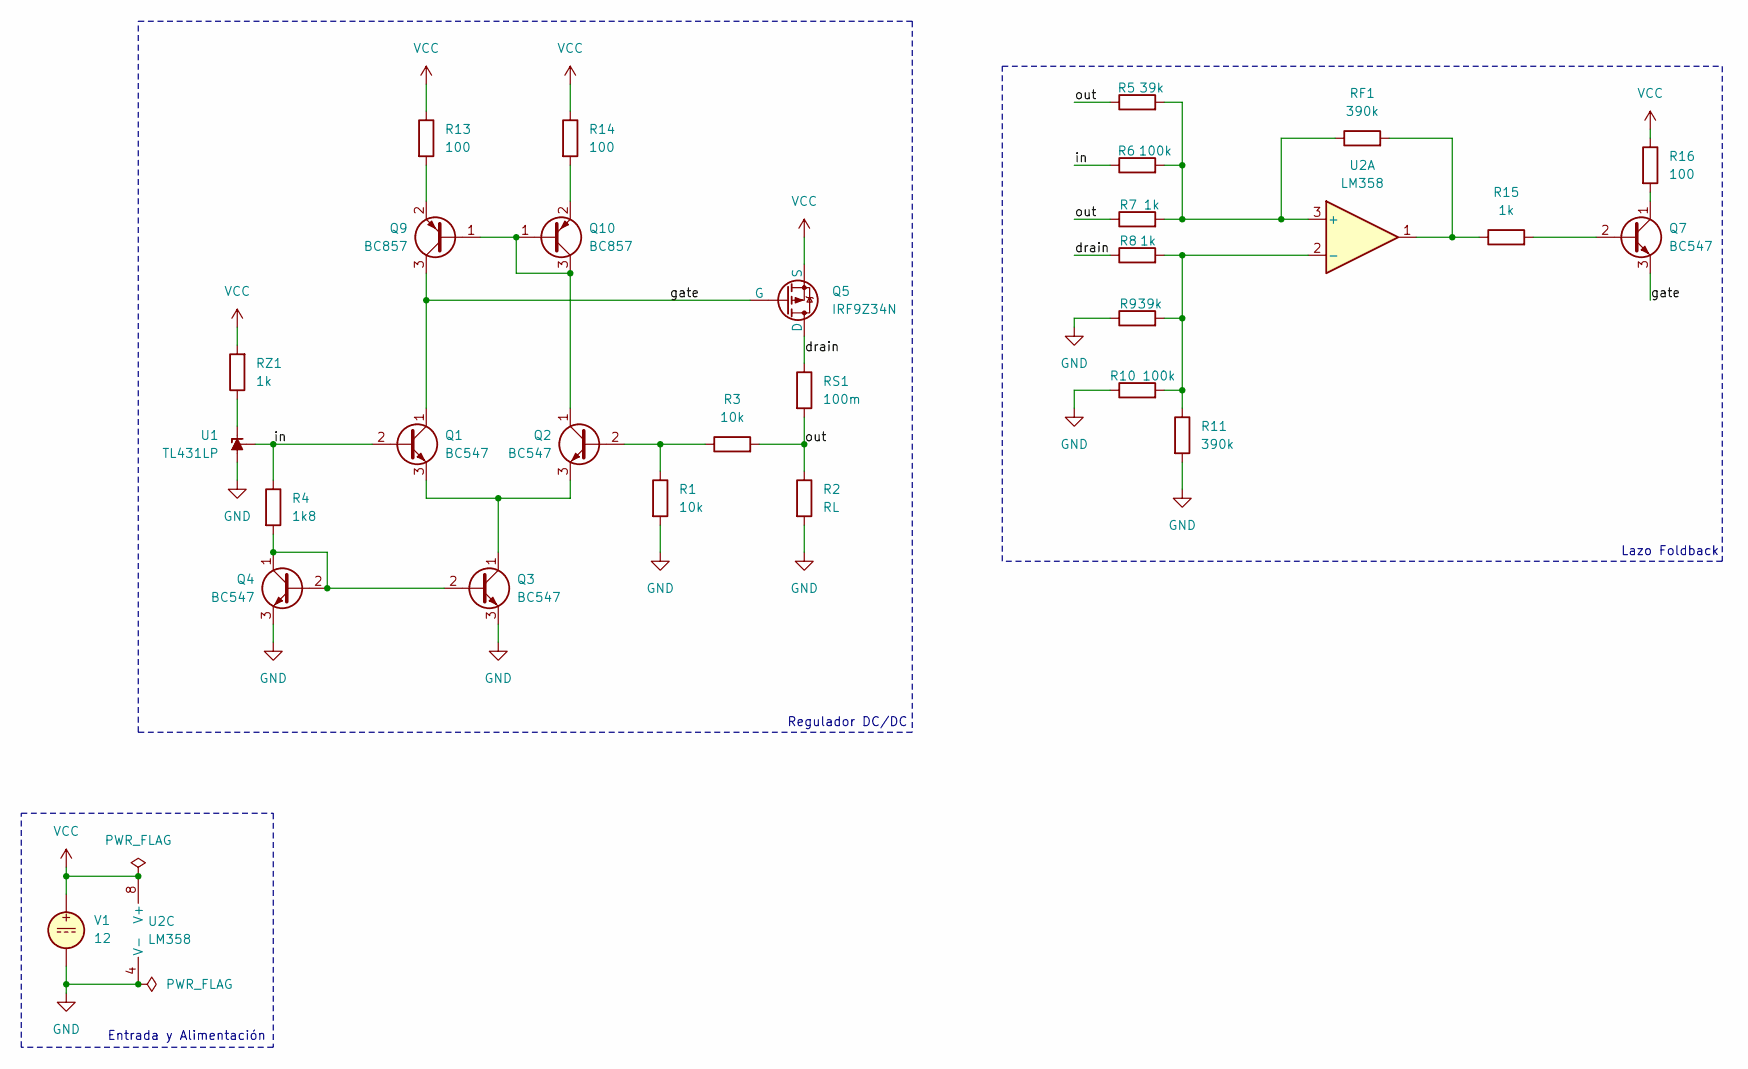
[picture p48: schematic Esquema_y_PCB.kicad_sch, Trabajo Práctico Integrador]

Parts:
Q1, Q2, Q3, Q4, Q7: BC547; TO-92_Inline
Q5: IRF9Z34N; TO-220-3_Vertical
Q9, Q10: BC857; TO-92_Inline
R1, R3: 10k; R_Axial_DIN0204_L3.6mm_D1.6mm_P5.08mm_Horizontal
R2: RL; TerminalBlock_MaiXu_MX126-5.0-02P_1x02_P5.00mm
R4: 1k8; R_Axial_DIN0204_L3.6mm_D1.6mm_P5.08mm_Horizontal
R5, R9: 39k; R_Axial_DIN0204_L3.6mm_D1.6mm_P5.08mm_Horizontal
R6, R10: 100k; R_Axial_DIN0204_L3.6mm_D1.6mm_P5.08mm_Horizontal
R7, R8, R15: 1k; R_Axial_DIN0204_L3.6mm_D1.6mm_P5.08mm_Horizontal
R11: 390k; R_Axial_DIN0204_L3.6mm_D1.6mm_P5.08mm_Horizontal
R13, R14, R16: 100; R_Axial_DIN0204_L3.6mm_D1.6mm_P5.08mm_Horizontal
RF1: 390k; R_Axial_DIN0204_L3.6mm_D1.6mm_P5.08mm_Horizontal
RS1: 100m; R_Axial_DIN0414_L11.9mm_D4.5mm_P15.24mm_Horizontal
RZ1: 1k; R_Axial_DIN0204_L3.6mm_D1.6mm_P5.08mm_Horizontal
U1: TL431LP; TO-92_Inline
U2: LM358; DIP-8_W7.62mm_Socket_LongPads
V1: 12; TerminalBlock_MaiXu_MX126-5.0-02P_1x02_P5.00mm

Connections:
/drain: Q5.1 (D), R8.1, RS1.1
/gate: Q1.1 (C), Q5.2 (G), Q7.3 (E), Q9.3 (C)
/in: Q1.2 (B), R4.1, R6.1, U1.1 (REF)
/out: R2.1, R3.2, R5.1, R7.1, RS1.2
GND: Q3.3 (E), Q4.3 (E), R1.2, R2.2, R9.1, R10.1, R11.2, U1.2 (A), U2.4 (V-), V1.2
unnamed: Q1.3 (E), Q2.3 (E), Q3.1 (C)
unnamed: Q2.2 (B), R1.1, R3.1
unnamed: Q3.2 (B), Q4.1 (C), Q4.2 (B), R4.2
unnamed: Q7.2 (B), R15.2
unnamed: Q7.1 (C), R16.2
unnamed: Q9.2 (E), R13.2
unnamed: Q2.1 (C), Q9.1 (B), Q10.1 (B), Q10.3 (C)
unnamed: Q10.2 (E), R14.2
unnamed: R15.1, RF1.2, U2.1
unnamed: RZ1.1, U1.3 (K)
unnamed: R5.2, R6.2, R7.2, RF1.1, U2.3 (+)
unnamed: R8.2, R9.2, R10.2, R11.1, U2.2 (-)
VCC: Q5.3 (S), R13.1, R14.1, R16.1, RZ1.2, U2.8 (V+), V1.1

Notes on the sheet:
Lazo Foldback
Regulador DC/DC
Entrada y Alimentación

Board: 2 copper layers, 29 parts (0 on the bottom side), 18 nets, no tracks yet.
