FranciscoRozenberg/TDCE/(commit log)

2026-08-30 Iteracines para llegar al regulador de tension diferencial con PMOS de paso
2026-08-31 Cambio fuentes de corrientes ideales por fuentes de corriente con transistores
2026-08-31 Resolucion de merge con Nahue
2026-08-31 Integracion de branches
2026-09-09 Ordenamiento de carpetas archivo principal en main
2026-09-09 Mas de lo mismo
2026-09-09 Más de lo mismo
2026-09-09 Agrego TL431
    [Esquema_y_PCB.kicad_sch]
2026-09-09 Corrección de Foldback
2026-09-09 Diseño fuente lineal con huellas
    [Esquema_y_PCB.kicad_pcb]
2026-09-21 se agrega IRF9Z34N al circuito
2026-09-25 Revision 2 del esquema para diseño con huellas
    [Esquema_y_PCB.kicad_pcb, Esquema_y_PCB.kicad_sch]
2026-09-25 PCB para impresion. Se modifican Jumpers en esquematico
    [Esquema_y_PCB.kicad_pcb, Esquema_y_PCB.kicad_sch]
2026-10-03 Rehecho PCB
    [Esquema_y_PCB.csv, Esquema_y_PCB.kicad_pcb, Esquema_y_PCB.kicad_sch]
2026-10-04 Reversion del PCB
2026-10-31 carpeta para ch4
2026-11-06 pwm y coso
2026-11-07 cambios hechos en dia de mierda
2026-11-08 rehacer PWM
2026-11-09 Ruteo del PWM (wip)
2026-11-12 EL PUTO PCB
2026-11-12 para que pase el DRC
